Elektrokrouzek-cz/useless-box-555/3d/uselessbox-top-1.stl

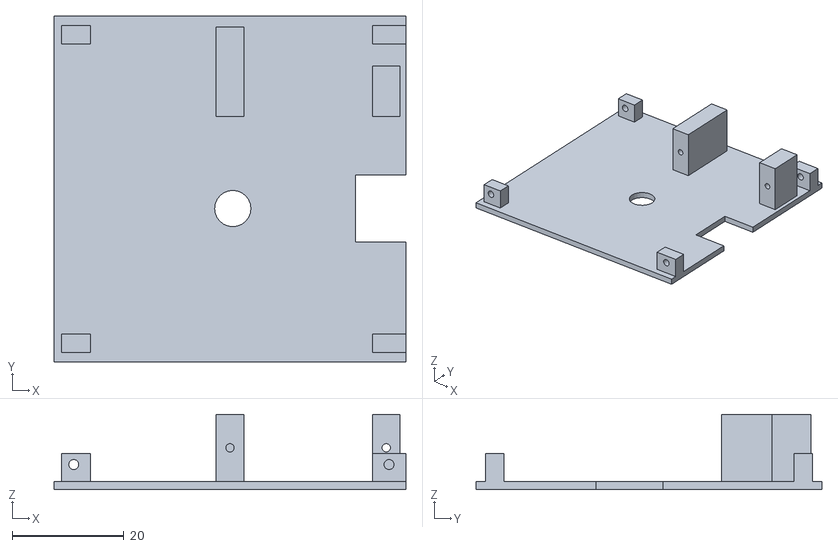
[picture p3: CAD file, 2025-03-14]
3d/uselessbox-top-1.stl
63.0 x 62.0 x 13.5
