Elektrokrouzek-cz/useless-box-555/3d/uselessbox-top-2.stl

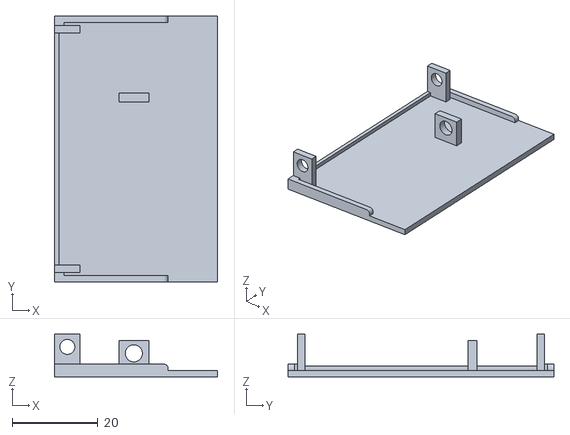
[picture p4: CAD file, 2025-02-08]
3d/uselessbox-top-2.stl
38.0 x 62.0 x 10.0
