Elektrokrouzek-cz/useless-box-555/3d/uselessbox-arm.stl

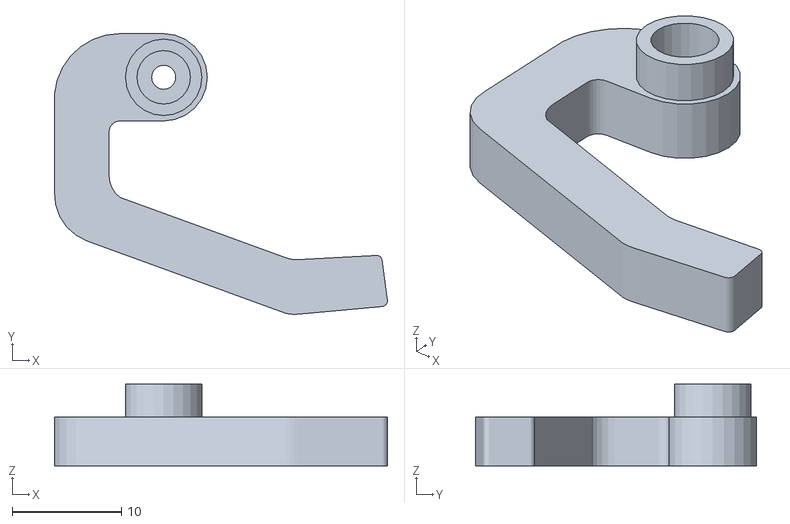
[picture p5: CAD file, 2025-02-08]
3d/uselessbox-arm.stl
30.5 x 25.7 x 7.50
