Elektrokrouzek-cz/useless-box-555/3d/uselessbox-bottom.stl

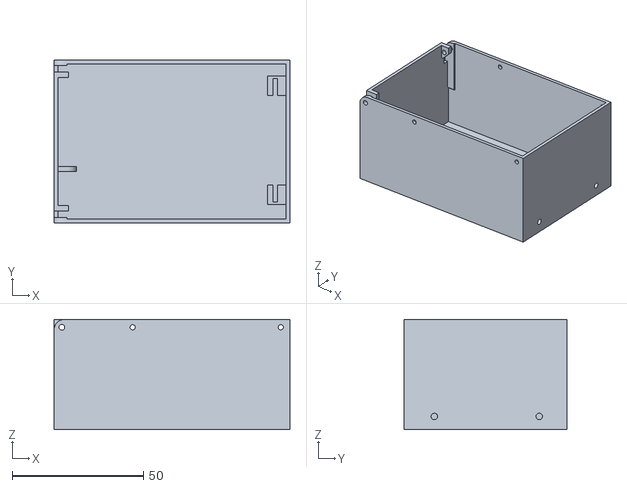
[picture p6: CAD file, 2025-02-08]
3d/uselessbox-bottom.stl
90.0 x 62.0 x 42.0
