Elektrokrouzek-cz/useless-box-555/(list of files, cad)

Other CAD files:
3d/uselessbox-arm.f3d
3d/uselessbox-bottom.f3d
3d/uselessbox-top-1.f3d
3d/uselessbox-top-2.f3d
