Elektrokrouzek-cz/useless-box-555/doc/UselessBox - Schematic.pdf

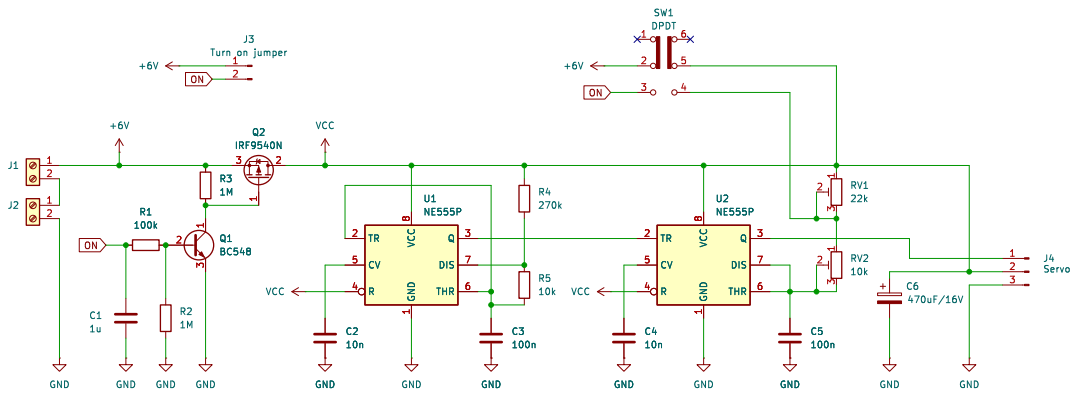
[picture p7: page 1]

File: UselessBox.kicad_sch Sheet: / www.elektrokrouzek.cz C4

Id: 1/1 Title: NE555 useless box
