Elektrokrouzek-cz/useless-box-555/doc/UselessBox - Assembly Drawing Top.pdf

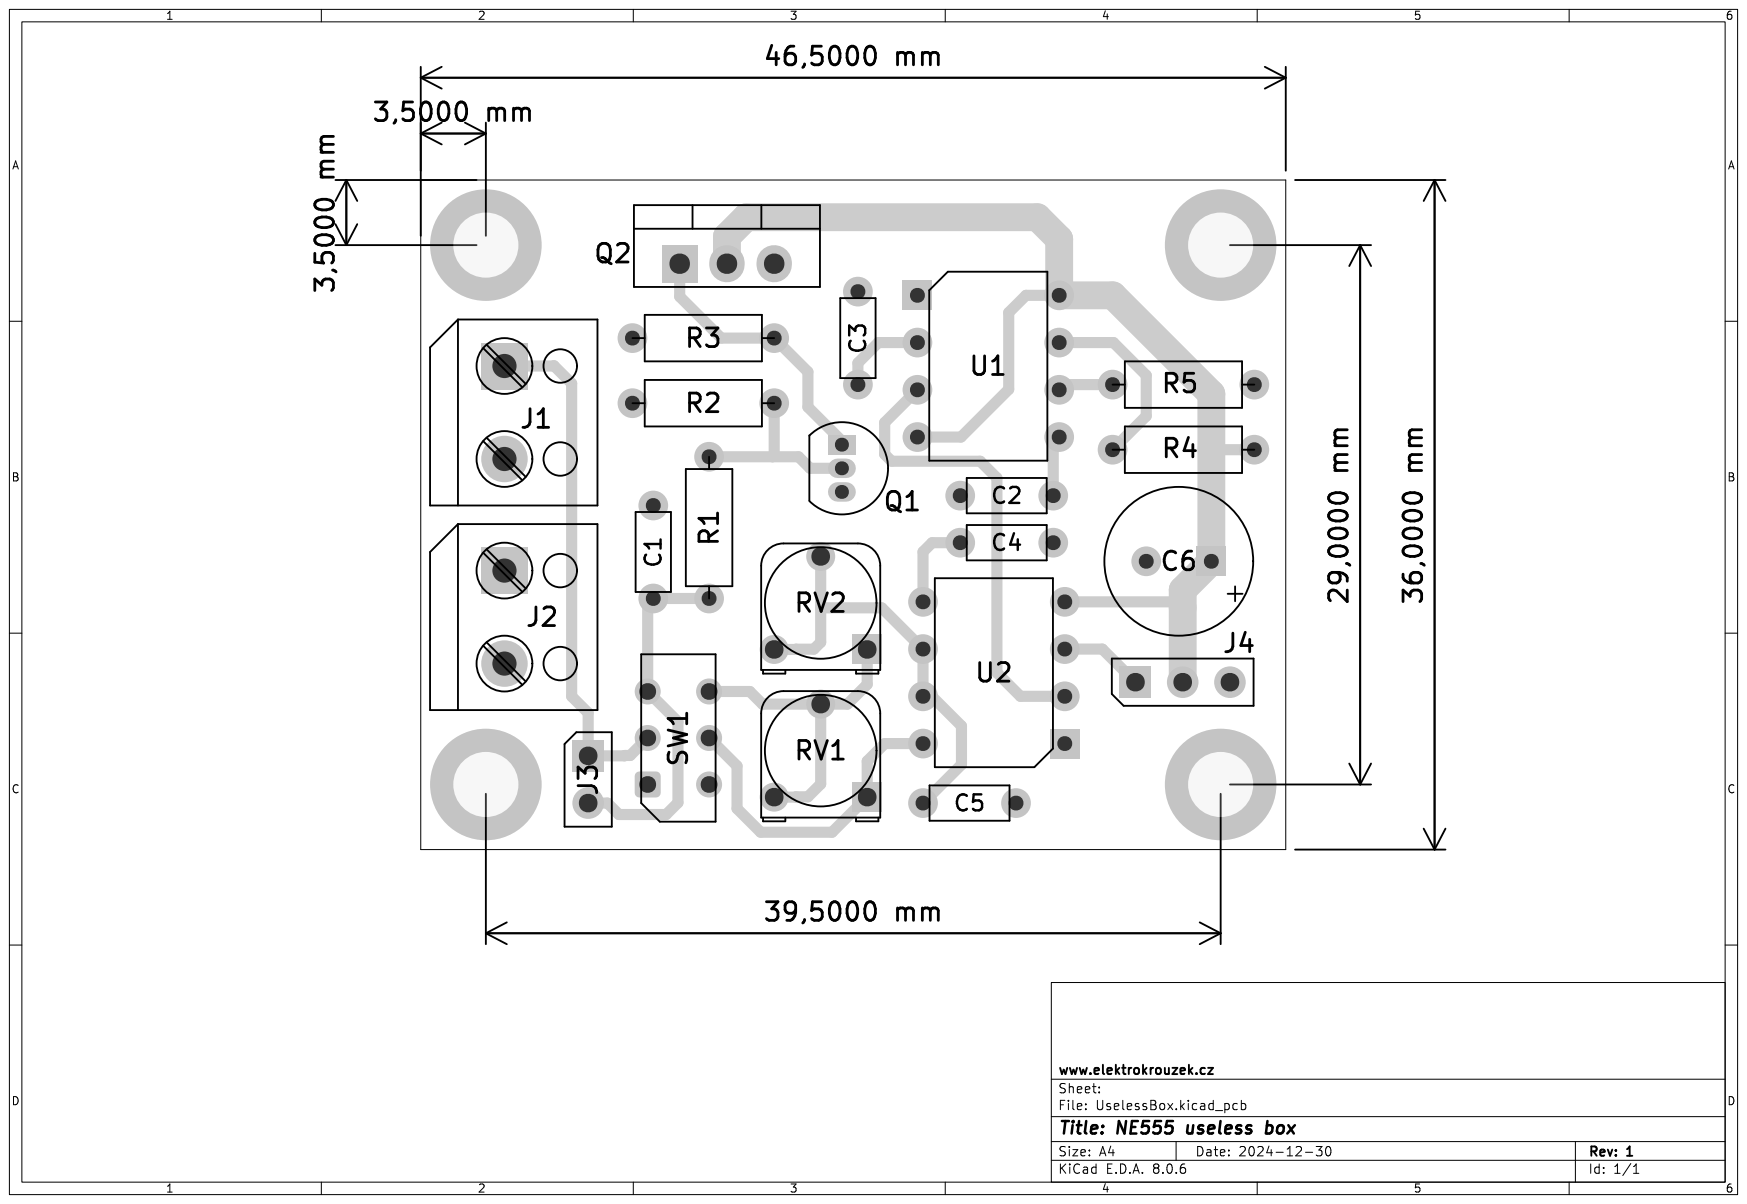
[picture p8: page 1]
