Elektrokrouzek-cz/useless-box-555/kicad/UselessBox.kicad_pcb

## KiCad design kicad/UselessBox.kicad_pcb (2024-12-30)

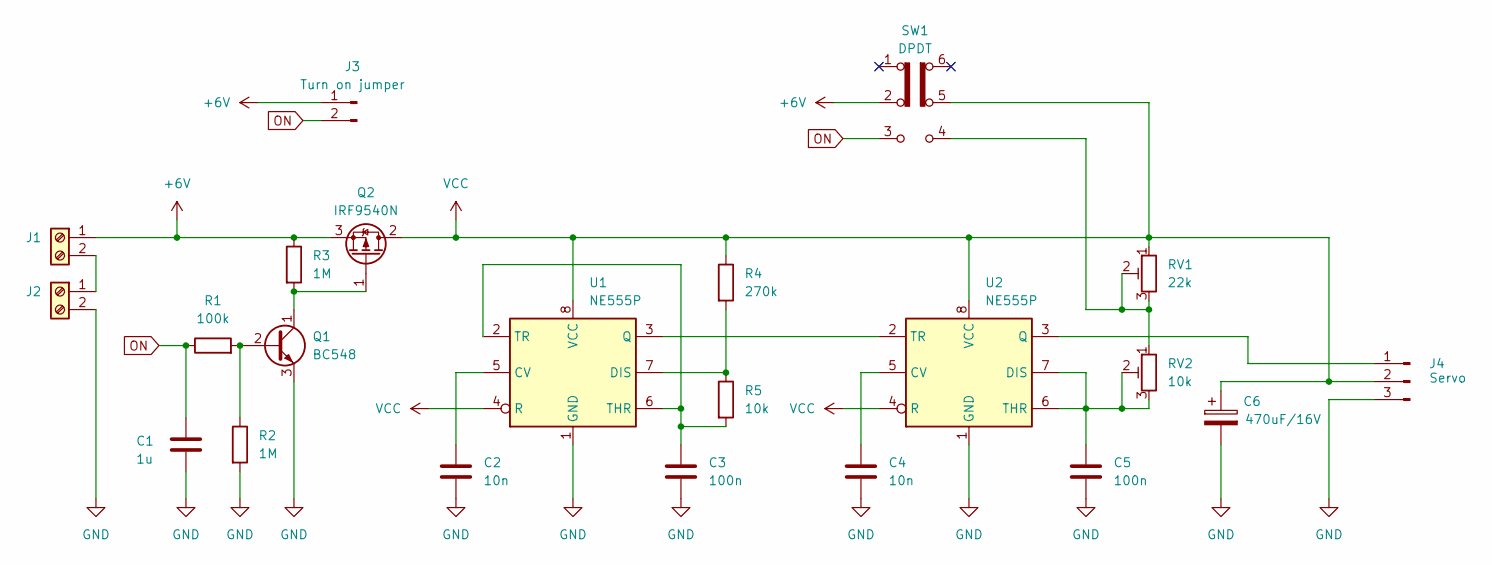
[picture p9: schematic UselessBox.kicad_sch, NE555 useless box]

Parts:
C1: 1u; C_Disc_D4.3mm_W1.9mm_P5.00mm
C2, C4: 10n; C_Disc_D4.3mm_W1.9mm_P5.00mm
C3, C5: 100n; C_Disc_D4.3mm_W1.9mm_P5.00mm
C6: 470uF/16V; CP_Radial_D8.0mm_P3.50mm
J1, J2: Screw_Terminal_01x02; TerminalBlock_RND_205-00001_1x02_P5.00mm_Horizontal
J3: Turn on jumper; PinHeader_1x02_P2.54mm_Vertical
J4: Servo; PinHeader_1x03_P2.54mm_Vertical
Q1: BC548; TO-92_Inline
Q2: IRF9540N; TO-220-3_Vertical
R1: 100k; R_Axial_DIN0207_L6.3mm_D2.5mm_P7.62mm_Horizontal
R2, R3: 1M; R_Axial_DIN0207_L6.3mm_D2.5mm_P7.62mm_Horizontal
R4: 270k; R_Axial_DIN0207_L6.3mm_D2.5mm_P7.62mm_Horizontal
R5: 10k; R_Axial_DIN0207_L6.3mm_D2.5mm_P7.62mm_Horizontal
RV1: 22k; Potentiometer_Runtron_RM-065_Vertical
RV2: 10k; Potentiometer_Runtron_RM-065_Vertical
SW1: DPDT; SW_CK_JS202011CQN_DPDT_Straight
U1, U2: NE555P; DIP-8_W7.62mm

Connections:
+6V: J1.1, J3.1, Q2.3 (S), R3.1, SW1.2 (B)
GND: C1.1, C2.2, C3.2, C4.2, C5.2, C6.2, J2.2, J4.3, Q1.3 (E), R2.2, U1.1 (GND), U2.1 (GND)
unnamed: J1.2, J2.1
unnamed: J4.1, U2.3 (Q)
unnamed: Q1.2 (B), R1.2, R2.1
unnamed: Q1.1 (C), Q2.1 (G), R3.2
unnamed: RV1.2, RV1.3, RV2.1, SW1.4 (A)
unnamed: C2.1, U1.5 (CV)
unnamed: R4.2, R5.1, U1.7 (DIS)
unnamed: U1.3 (Q), U2.2 (TR)
unnamed: C3.1, R5.2, U1.2 (TR), U1.6 (THR)
unnamed: C4.1, U2.5 (CV)
unnamed: C5.1, RV2.2, RV2.3, U2.6 (THR), U2.7 (DIS)
ON: C1.2, J3.2, R1.1, SW1.3 (C)
VCC: C6.1, J4.2, Q2.2 (D), R4.1, RV1.1, SW1.5 (B), U1.4 (R), U1.8 (VCC), U2.4 (R), U2.8 (VCC)

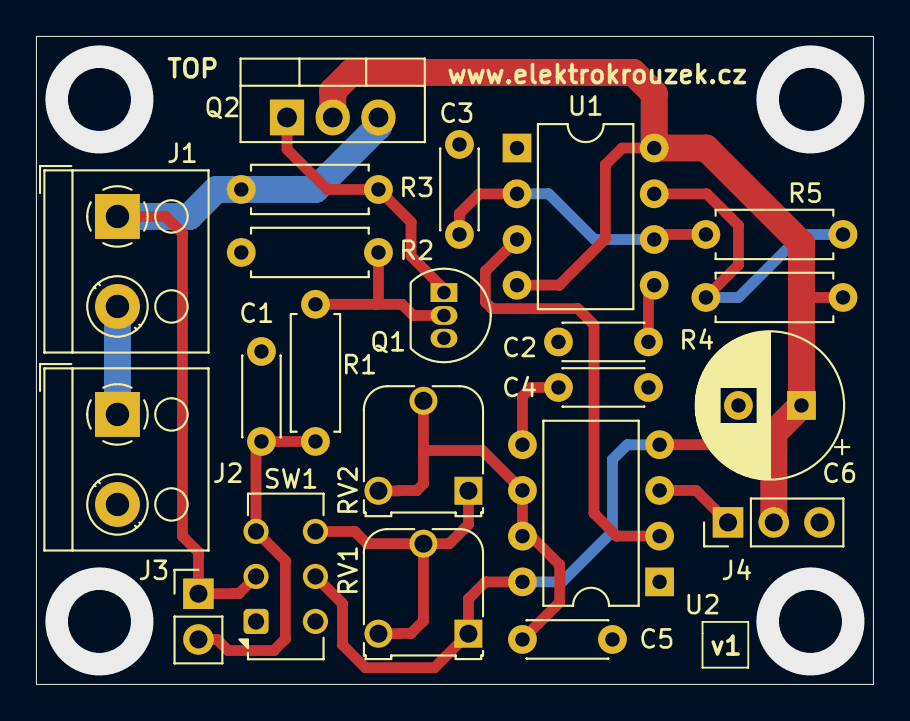
[picture p10: board UselessBox.kicad_pcb from above]

Board: 2 copper layers, 46.5 x 36.0 mm, 22 parts (0 on the bottom side), 15 nets.
