Elektrokrouzek-cz/useless-box-555/(commit log)

2024-12-30 Schematic added
2024-12-30 Mounting holes mask added
    [UselessBox-B_Cu.gbl, UselessBox-B_Mask.gbs, UselessBox-B_Paste.gbp, UselessBox-B_Silkscreen.gbo, UselessBox-Edge_Cuts.gm1, UselessBox-F_Cu.gtl, UselessBox-F_Mask.gts, UselessBox-F_Paste.gtp]
2024-12-30 Turn-on jumper added
    [UselessBox-B_Cu.gbl, UselessBox-B_Mask.gbs, UselessBox-B_Paste.gbp, UselessBox-B_Silkscreen.gbo, UselessBox-Edge_Cuts.gm1, UselessBox-F_Cu.gtl, UselessBox-F_Mask.gts, UselessBox-F_Paste.gtp]
2025-02-08 3D models, manuals
    [BOM.csv, uselessbox-arm.f3d, uselessbox-arm.stl, uselessbox-bottom.f3d, uselessbox-bottom.stl, uselessbox-top-1.f3d, uselessbox-top-1.stl, uselessbox-top-2.f3d]
2025-03-14 3D model update
    [uselessbox-top-1.stl]
